Sashulik/stitch-jump-costume/docs/data_to_model_workflow_20261008_v01.png

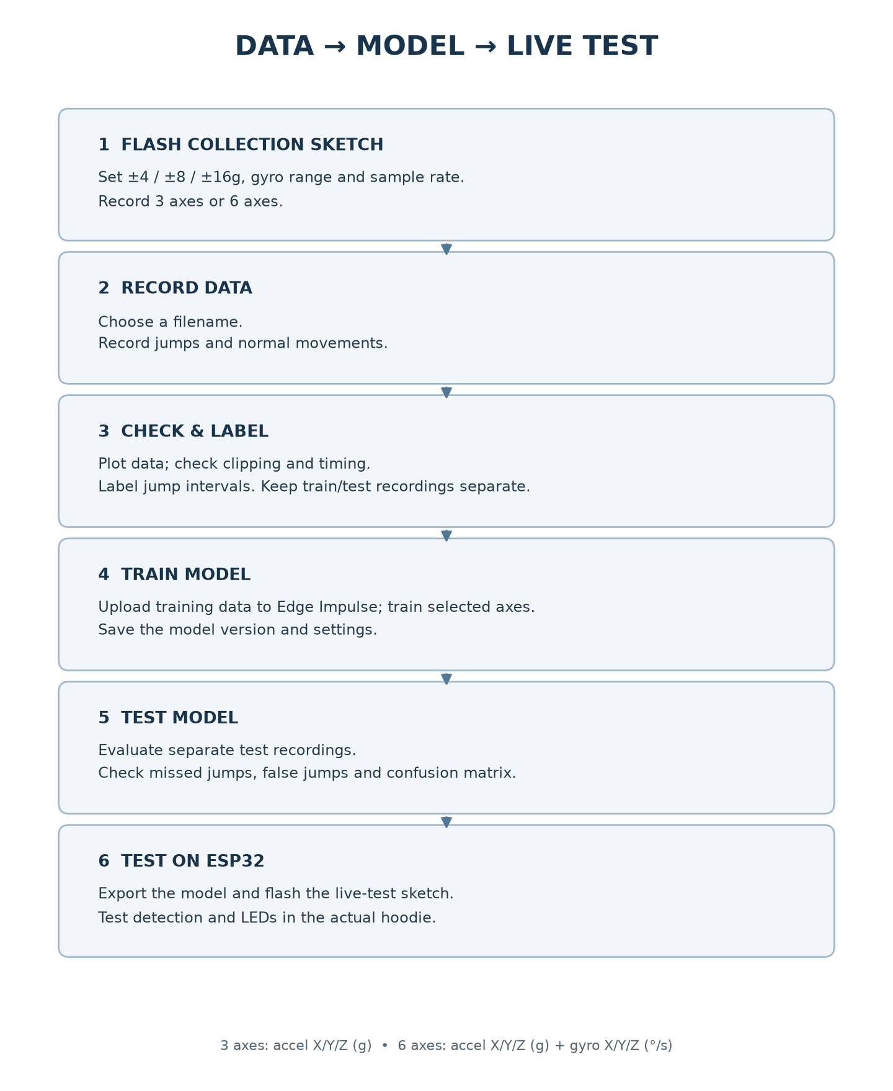
docs/data_to_model_workflow_20261008_v01.png
